abhinavpramod23/fsae-bspd/(list of files, drawings)

Other design files:
hardware/altium/bspd.PcbDoc
hardware/altium/bspd.PcbLib
hardware/altium/bspd.PrjPcb
hardware/altium/bspd.SchDoc
hardware/altium/bspd.SchLib
