abhinavpramod23/fsae-bspd/hardware/kicad/bspd.kicad_sch

## KiCad design hardware/kicad/bspd.kicad_sch (2026-11-04)

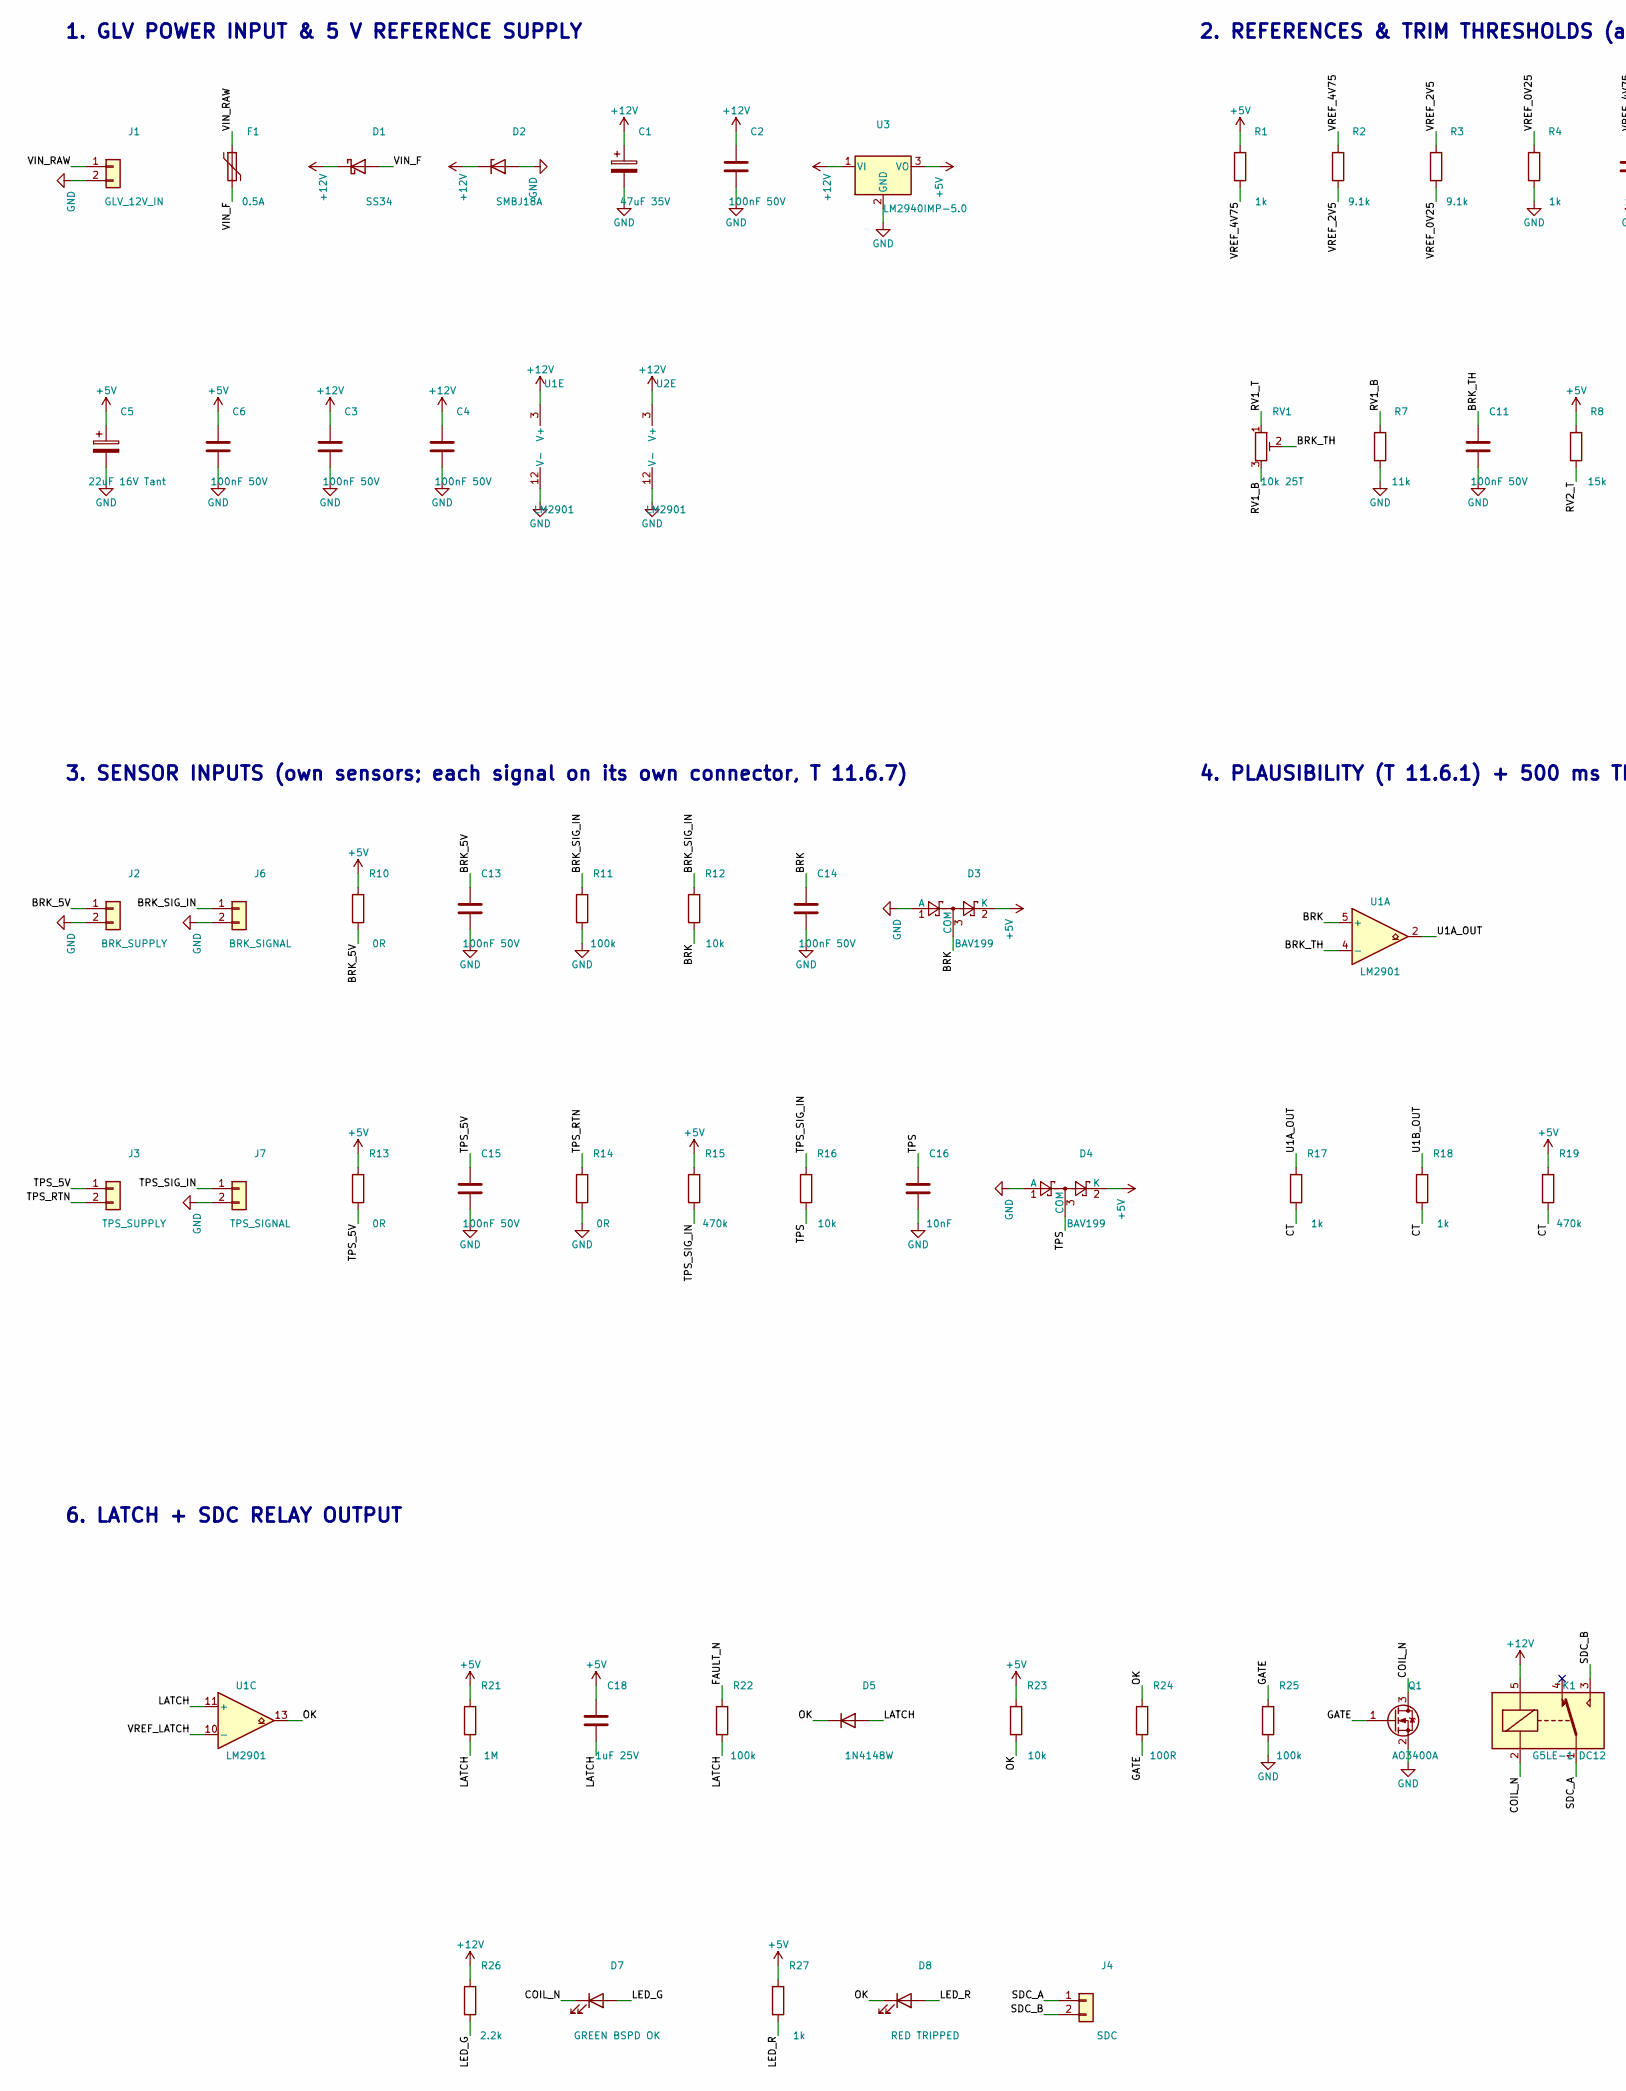
[picture p7: schematic bspd.kicad_sch, part in row 1, column 1]

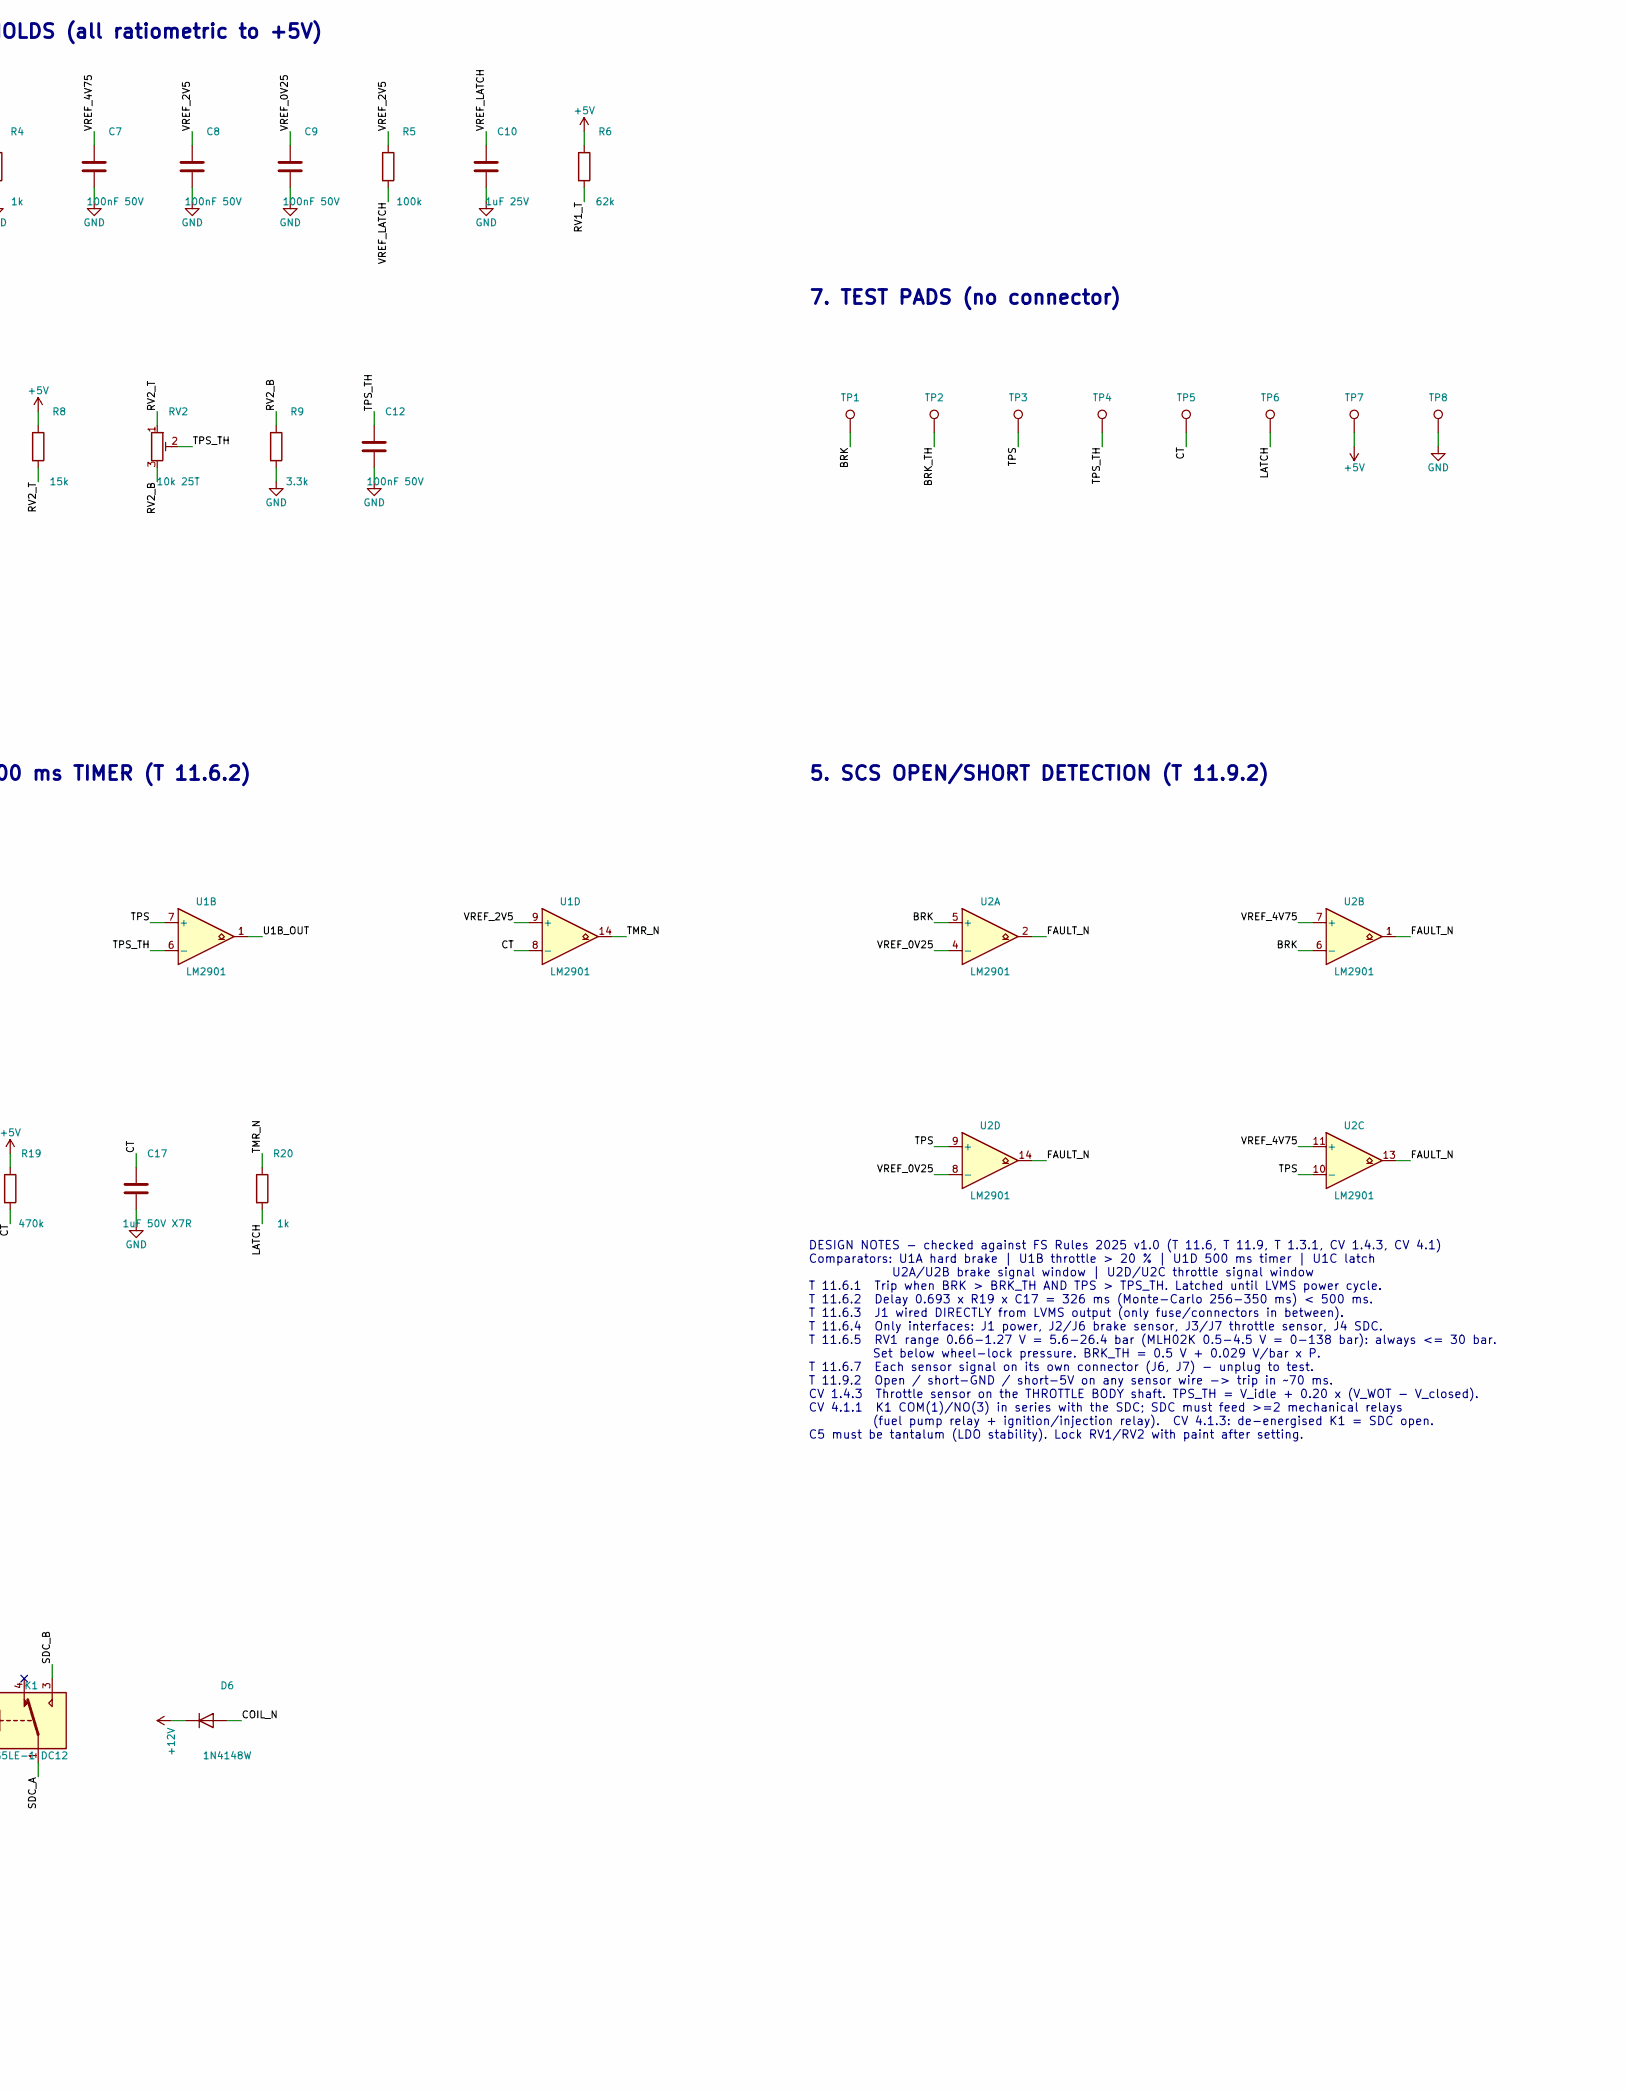
[picture p8: schematic bspd.kicad_sch, part in row 1, column 2]

Parts:
C1: 47uF 35V; CP_Elec_6.3x7.7; MPN Panasonic EEE-FK1V470P
C2, C3, C4, C6, C7, C8, C9, C11, C12, C13, C14, C15: 100nF 50V; C_0603_1608Metric; MPN Samsung CL10B104KB8NNNC
C5: 22uF 16V Tant; CP_EIA-3528-21_Kemet-B; MPN KEMET T491B226K016AT
C10, C18: 1uF 25V; C_0805_2012Metric; MPN Samsung CL21B105KAFNNNE
C16: 10nF; C_0603_1608Metric; MPN Samsung CL10B103KB8NNNC
C17: 1uF 50V X7R; C_1206_3216Metric; MPN Murata GRM31MR71H105KA88L
D1: SS34; D_SMA; MPN SS34 (onsemi/MCC)
D2: SMBJ18A; D_SMB; MPN Littelfuse SMBJ18A
D3, D4: BAV199; SOT-23; MPN Nexperia BAV199,215
D5, D6: 1N4148W; D_SOD-123; MPN Diodes Inc 1N4148W-7-F
D7: GREEN BSPD OK; LED_0805_2012Metric; MPN Kingbright APT2012SGC
D8: RED TRIPPED; LED_0805_2012Metric; MPN Kingbright APT2012SURCK
F1: 0.5A; Fuse_1812_4532Metric; MPN Bourns MF-MSMF050-2
J1: GLV_12V_IN; Molex_Micro-Fit_3.0_43650-0215_1x02_P3.00mm_Vertical; MPN Molex 43650-0215
J2: BRK_SUPPLY; Molex_Micro-Fit_3.0_43650-0215_1x02_P3.00mm_Vertical; MPN Molex 43650-0215
J3: TPS_SUPPLY; Molex_Micro-Fit_3.0_43650-0215_1x02_P3.00mm_Vertical; MPN Molex 43650-0215
J4: SDC; Molex_Micro-Fit_3.0_43650-0215_1x02_P3.00mm_Vertical; MPN Molex 43650-0215
J6: BRK_SIGNAL; Molex_Micro-Fit_3.0_43650-0215_1x02_P3.00mm_Vertical; MPN Molex 43650-0215
J7: TPS_SIGNAL; Molex_Micro-Fit_3.0_43650-0215_1x02_P3.00mm_Vertical; MPN Molex 43650-0215
K1: G5LE-1 DC12; Relay_SPDT_Omron-G5LE-1; MPN Omron G5LE-1 DC12
Q1: AO3400A; SOT-23; MPN AOS AO3400A
R1, R4, R17, R18, R20, R27: 1k; R_0603_1608Metric; MPN Yageo RC0603FR-071KL
R2, R3: 9.1k; R_0603_1608Metric; MPN Yageo RC0603FR-079K1L
R5, R11, R22, R25: 100k; R_0603_1608Metric; MPN Yageo RC0603FR-07100KL
R6: 62k; R_0603_1608Metric; MPN Yageo RC0603FR-0762KL
R7: 11k; R_0603_1608Metric; MPN Yageo RC0603FR-0711KL
R8: 15k; R_0603_1608Metric; MPN Yageo RC0603FR-0715KL
R9: 3.3k; R_0603_1608Metric; MPN Yageo RC0603FR-073K3L
R10: 0R; R_2512_6332Metric; MPN Yageo RC2512JK-070RL
R12, R16, R23: 10k; R_0603_1608Metric; MPN Yageo RC0603FR-0710KL
R13, R14: 0R; R_0603_1608Metric; MPN Yageo RC0603JR-070RL
R15, R19: 470k; R_0603_1608Metric; MPN Yageo RC0603FR-07470KL
R21: 1M; R_0603_1608Metric; MPN Yageo RC0603FR-071ML
R24: 100R; R_0603_1608Metric; MPN Yageo RC0603FR-07100RL
R26: 2.2k; R_0603_1608Metric; MPN Yageo RC0603FR-072K2L
RV1, RV2: 10k 25T; Potentiometer_Bourns_3296W_Vertical; MPN Bourns 3296W-1-103LF
TP1: BRK; TestPoint_Pad_D1.5mm; MPN PCB pad only (no part)
TP2: BRK_TH; TestPoint_Pad_D1.5mm; MPN PCB pad only (no part)
TP3: TPS; TestPoint_Pad_D1.5mm; MPN PCB pad only (no part)
TP4: TPS_TH; TestPoint_Pad_D1.5mm; MPN PCB pad only (no part)
TP5: CT; TestPoint_Pad_D1.5mm; MPN PCB pad only (no part)
TP6: LATCH; TestPoint_Pad_D1.5mm; MPN PCB pad only (no part)
TP7: +5V; TestPoint_Pad_D1.5mm; MPN PCB pad only (no part)
TP8: GND; TestPoint_Pad_D1.5mm; MPN PCB pad only (no part)
U1, U2: LM2901; SOIC-14_3.9x8.7mm_P1.27mm; MPN TI LM2901DR
U3: LM2940IMP-5.0; SOT-223-3_TabPin2; MPN TI LM2940IMP-5.0/NOPB

Connections:
+5V: C5.1, C6.1, C18.1, D3.2 (K), D4.2 (K), R1.1, R6.1, R8.1, R10.1, R13.1, R15.1, R19.1, R21.1, R23.1, R27.1, TP7.1, U3.3 (VO)
+12V: C1.1, C2.1, C3.1, C4.1, D1.1 (K), D2.1 (K), D6.1 (K), K1.5, R26.1, U1.3 (V+), U2.3 (V+), U3.1 (VI)
BRK: C14.1, D3.3 (COM), R12.2, TP1.1, U1.5 (+), U2.5 (+), U2.6 (-)
BRK_5V: C13.1, J2.1, R10.2
BRK_SIG_IN: J6.1, R11.1, R12.1
BRK_TH: C11.1, RV1.2, TP2.1, U1.4 (-)
COIL_N: D6.2 (A), D7.1 (K), K1.2, Q1.3 (D)
CT: C17.1, R17.2, R18.2, R19.2, TP5.1, U1.8 (-)
FAULT_N: R22.1, U2.1, U2.2, U2.13, U2.14
GATE: Q1.1 (G), R24.2, R25.1
GND: C1.2, C2.2, C3.2, C4.2, C5.2, C6.2, C7.2, C8.2, C9.2, C10.2, C11.2, C12.2, C13.2, C14.2, C15.2, C16.2, C17.2, D2.2 (A), D3.1 (A), D4.1 (A), J1.2, J2.2, J6.2, J7.2, Q1.2 (S), R4.2, R7.2, R9.2, R11.2, R14.2, R25.2, TP8.1, U1.12 (V-), U2.12 (V-), U3.2 (GND)
LATCH: C18.2, D5.2 (A), R20.2, R21.2, R22.2, TP6.1, U1.11 (+)
LED_G: D7.2 (A), R26.2
LED_R: D8.2 (A), R27.2
OK: D5.1 (K), D8.1 (K), R23.2, R24.1, U1.13
RV1_B: R7.1, RV1.3
RV1_T: R6.2, RV1.1
RV2_B: R9.1, RV2.3
RV2_T: R8.2, RV2.1
SDC_A: J4.1, K1.1
SDC_B: J4.2, K1.3
TMR_N: R20.1, U1.14
TPS: C16.1, D4.3 (COM), R16.2, TP3.1, U1.7 (+), U2.9 (+), U2.10 (-)
TPS_5V: C15.1, J3.1, R13.2
TPS_RTN: J3.2, R14.1
TPS_SIG_IN: J7.1, R15.2, R16.1
TPS_TH: C12.1, RV2.2, TP4.1, U1.6 (-)
U1A_OUT: R17.1, U1.2
U1B_OUT: R18.1, U1.1
VIN_F: D1.2 (A), F1.2
VIN_RAW: F1.1, J1.1
VREF_0V25: C9.1, R3.2, R4.1, U2.4 (-), U2.8 (-)
VREF_2V5: C8.1, R2.2, R3.1, R5.1, U1.9 (+)
VREF_4V75: C7.1, R1.2, R2.1, U2.7 (+), U2.11 (+)
VREF_LATCH: C10.1, R5.2, U1.10 (-)

Notes on the sheet:
1. GLV POWER INPUT & 5 V REFERENCE SUPPLY
2. REFERENCES & TRIM THRESHOLDS (all ratiometric to +5V)
3. SENSOR INPUTS (own sensors; each signal on its own connector, T 11.6.7)
4. PLAUSIBILITY (T 11.6.1) + 500 ms TIMER (T 11.6.2)
5. SCS OPEN/SHORT DETECTION (T 11.9.2)
6. LATCH + SDC RELAY OUTPUT
7. TEST PADS (no connector)
DESIGN NOTES - checked against FS Rules 2025 v1.0 (T 11.6, T 11.9, T 1.3.1, CV 1.4.3, CV 4.1) Comparators: U1A hard brake | U1B throttle > 20 % | U1D 500 ms timer | U1C latch U2A/U2B brake signal window | U2D/U2C throttle signal window T 11.6.1 Trip when BRK > BRK_TH AND TPS > TPS_TH. Latched until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
