abhinavpramod23/fsae-bspd/(commit log)

2026-11-03 BSPD Rev B: schematic, Altium PCB (DRC clean), Gerbers, simulation, BOM
    [BOM.csv, bspd.PcbLib, bspd.PrjPcb, bspd.SchLib, bspd.kicad_sch, bspd.pcb, bspd.sch]
2026-11-03 Fix Altium project paths
    [bspd.PrjPcb]
2026-11-04 DFM fix: non-plated Micro-Fit peg holes, regenerated Gerbers
    [bspd.pcb]
2026-11-04 Rev B.1: 0R sensor links, BAV199 clamps; Altium files renamed to SchDoc/PcbDoc
    [BOM.csv, bspd.PcbDoc, bspd.PrjPcb, bspd.SchDoc, bspd.kicad_sch, bspd.pcb, bspd.sch]
